soramimi/avrhvpp/(list of files, drawings)

Other design files:
pcb/avrpara.dsn
