soramimi/avrhvpp/pcb/avrpara.kicad_pcb

## KiCad design pcb/avrpara.kicad_pcb (2026-11-03)

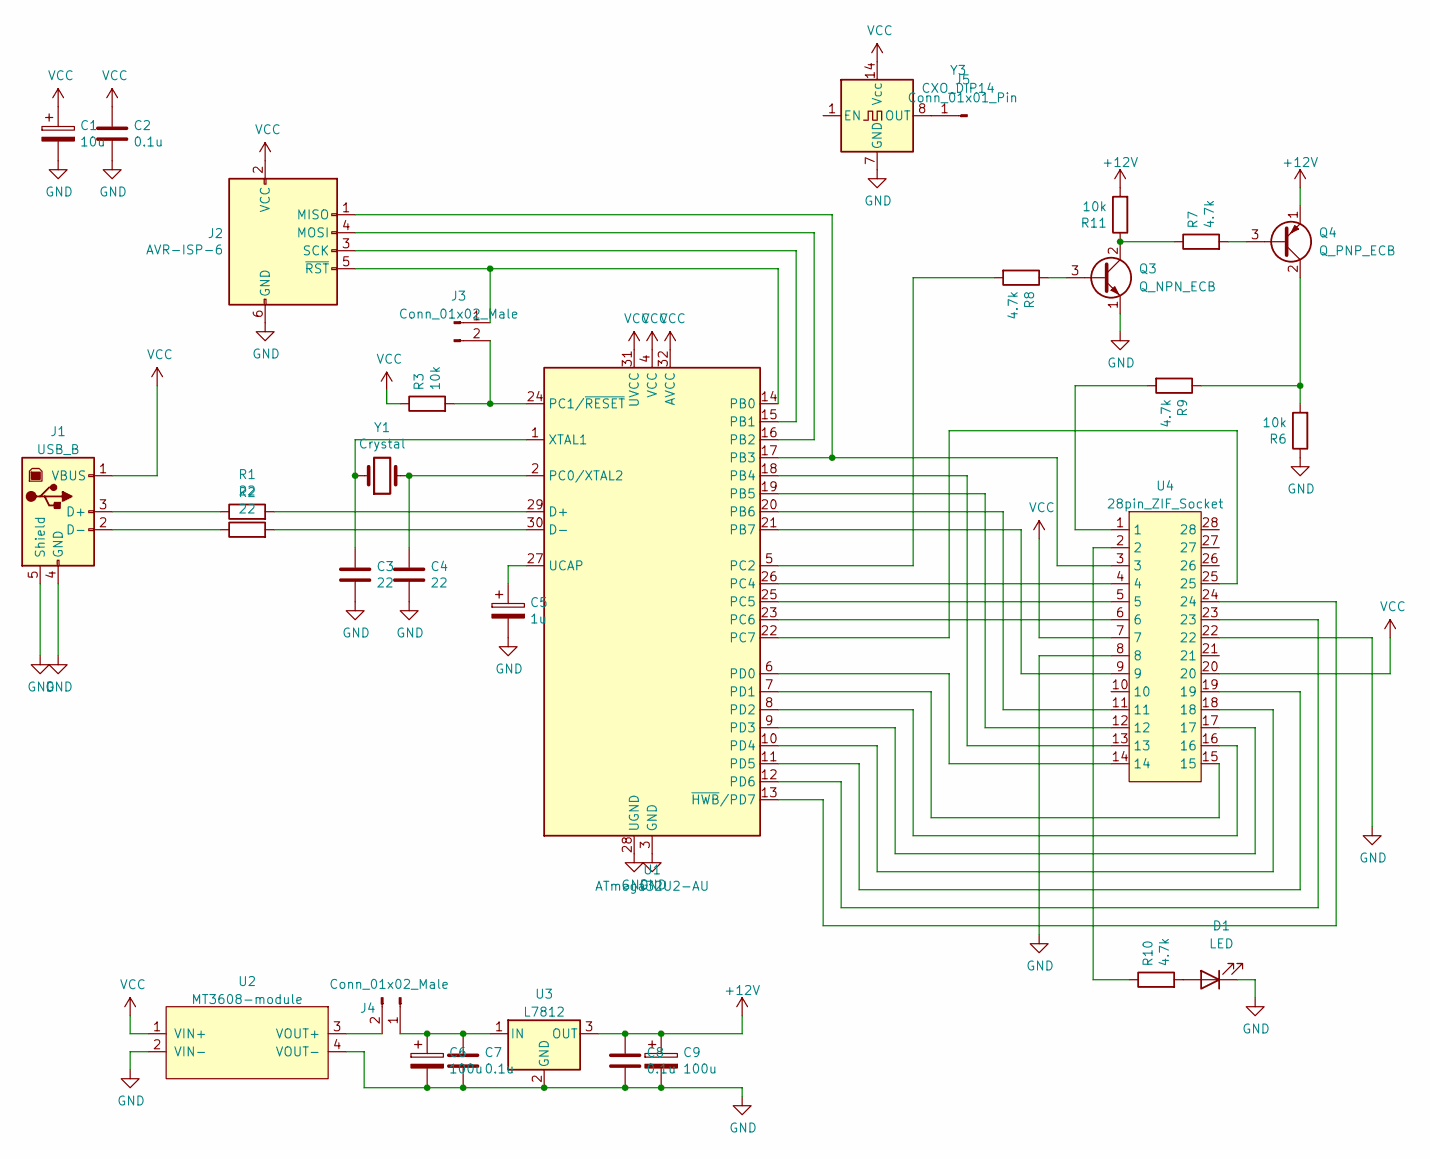
[picture p1: schematic avrpara.kicad_sch]

Parts:
C1: 10u; CP_Radial_D6.3mm_P2.50mm
C2, C7, C8: 0.1u; C_Disc_D3.0mm_W1.6mm_P2.50mm
C3, C4: 22; C_Disc_D3.0mm_W1.6mm_P2.50mm
C5: 1u; CP_Radial_D6.3mm_P2.50mm
C6, C9: 100u; CP_Radial_D6.3mm_P2.50mm
D1: LED; LED_D3.0mm
J1: USB_B; USB_B_Lumberg_2411_02_Horizontal
J2: AVR-ISP-6; PinHeader_2x03_P2.54mm_Vertical
J3, J4: Conn_01x02_Male; PinHeader_1x02_P2.54mm_Vertical
J5: Conn_01x01_Pin; PinHeader_1x01_P2.54mm_Vertical
Q3: Q_NPN_ECB; TO-92L_Inline_Wide
Q4: Q_PNP_ECB; TO-92L_Inline_Wide
R1, R2: 22; R_Axial_DIN0204_L3.6mm_D1.6mm_P2.54mm_Vertical
R3, R6, R11: 10k; R_Axial_DIN0204_L3.6mm_D1.6mm_P2.54mm_Vertical
R7, R8, R9: 4.7k; R_Axial_DIN0204_L3.6mm_D1.6mm_P2.54mm_Vertical
R10: 4.7k; R_Axial_DIN0207_L6.3mm_D2.5mm_P2.54mm_Vertical
U1: ATmega32U2-AU; TQFP-32_7x7mm_P0.8mm
U2: MT3608-module
U3: L7812; TO-220-3_Vertical
U4: 28pin_ZIF_Socket; ARIES 28pin ZIF Socket
Y1: Crystal; Crystal_HC49-U_Vertical
Y3: CXO_DIP14; Oscillator_DIP-14

Connections:
+12V: C8.1, C9.1, Q4.1 (E), R11.2, U3.3 (OUT)
GND: C1.2, C2.2, C3.2, C4.2, C5.2, C6.2, C7.2, C8.2, C9.2, D1.1 (K), J1.4 (GND), J1.5 (Shield), J2.6 (GND), Q3.1 (E), R6.1, U1.3 (GND), U1.28 (UGND), U2.2 (VIN-), U2.4 (VOUT-), U3.2 (GND), U4.8, U4.22, Y3.7 (GND)
unnamed: D1.2 (A), R10.2
unnamed: J1.3 (D+), R1.1
unnamed: J1.2 (D-), R2.1
unnamed: J2.1 (MISO), U1.17 (PB3), U4.3
unnamed: J2.4 (MOSI), U1.16 (PB2)
unnamed: J2.3 (SCK), U1.15 (PB1)
unnamed: J2.5 (~RST), J3.1, U1.14 (PB0)
unnamed: J3.2, R3.2, U1.24 (PC1/~RESET)
unnamed: C6.1, C7.1, J4.1, U3.1 (IN)
unnamed: J4.2, U2.3 (VOUT+)
unnamed: J5.1 (Pin_1_1), Y3.8 (OUT)
unnamed: Q3.3 (B), R8.1
unnamed: Q3.2 (C), R7.1, R11.1
unnamed: Q4.3 (B), R7.2
unnamed: Q4.2 (C), R6.2, R9.1
unnamed: R9.2, U4.1
unnamed: R10.1, U4.2
unnamed: R1.2, U1.29 (D+)
unnamed: R2.2, U1.30 (D-)
unnamed: U1.18 (PB4), U4.13
unnamed: U1.19 (PB5), U4.12
unnamed: U1.20 (PB6), U4.11
unnamed: U1.21 (PB7), U4.9
unnamed: C4.1, U1.2 (PC0/XTAL2), Y1.2
unnamed: R8.2, U1.5 (PC2)
unnamed: U1.26 (PC4), U4.4
unnamed: U1.25 (PC5), U4.5
unnamed: U1.23 (PC6), U4.6
unnamed: U1.22 (PC7), U4.25
unnamed: U1.6 (PD0), U4.14
unnamed: U1.7 (PD1), U4.15
unnamed: U1.8 (PD2), U4.16
unnamed: U1.9 (PD3), U4.17
unnamed: U1.10 (PD4), U4.18
unnamed: U1.11 (PD5), U4.19
unnamed: U1.12 (PD6), U4.23
unnamed: C5.1, U1.27 (UCAP)
unnamed: C3.1, U1.1 (XTAL1), Y1.1
unnamed: U1.13 (~HWB/PD7), U4.24
VCC: C1.1, C2.1, J1.1 (VBUS), J2.2 (VCC), R3.1, U1.4 (VCC), U1.31 (UVCC), U1.32 (AVCC), U2.1 (VIN+), U4.7, U4.20, Y3.14 (Vcc)

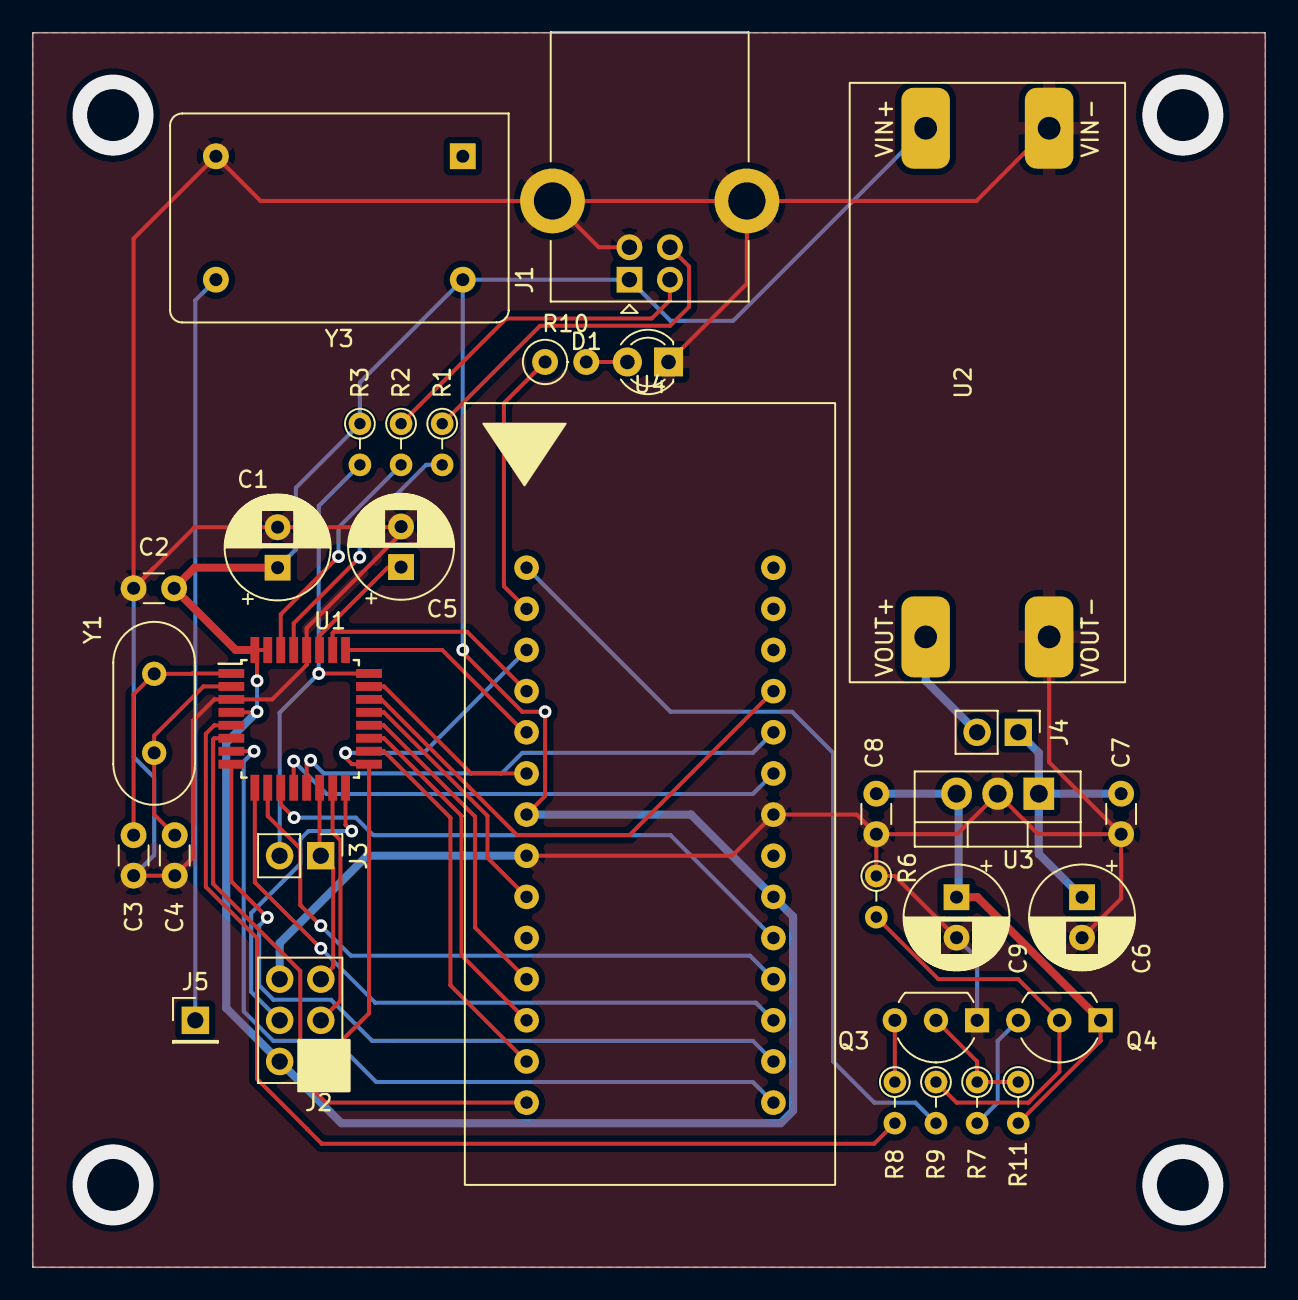
[picture p2: board avrpara.kicad_pcb from above]

Board: 2 copper layers, 76.1 x 76.2 mm, 32 parts (0 on the bottom side), 42 nets.
