soramimi/avrhvpp/(commit log)

2026-10-27 Introduce read_line helper, timeout constants, and --restore-fuse option in host tool
2026-11-01 Introduce common/commands.h and refactor AVR parallel command handling. Refactor read_fuse/write_fuse to use a Fuse enum and handle new protocol commands.
2026-11-01 Add fuse write, lock bit read/write and chip erase commands to AVRPARA mode
2026-11-01 pcb修正
    [avrpara.kicad_pcb, avrpara.kicad_sch]
2026-11-01 Add XTAL1 clock output on PB7 for AVRISP mode and add J5 test pin to PCB
    [avrpara.kicad_pcb, avrpara.kicad_sch]
2026-11-01 Add DIP-8 crystal oscillator to schematic and PCB
    [avrpara.kicad_pcb, avrpara.kicad_sch]
2026-11-04 Replace CMD_PAGE0/1 with 16-bit page number latched via CMD_LATCH_PAGE_NUM
    [avrhvpp.cpp, main.cpp]
2026-11-04 Add TargetDefinition data model for ATmega8 and ATmega328P and replace the compile-time Target type
    [avrhvpp.cpp, main.cpp, target.h]
2026-11-04 Rename --detect option to --query and add -q short alias
    [main.cpp, protocol.cpp]
2026-11-09 Add AVRISP device support with signature reading
2026-11-09 Refactor AVRISP signature reading into an Avrisp class with exact I/O and STK500 status validation. Add --device option parsing and reject unknown, duplicate, or unsupported AVRISP operations before 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
2026-11-09 Add STK500v1 firmware compatibility test with fake USB and SPI environment. Close AVRISP extension plan and record user hardware verification for all five chips.
